klebol/Klecontroller_PCB/Cntrl_materials.xlsx

Rodzaj | Wartość | Obudowa | Ilość | link | Stan
Rezystor | 100k | 0603 | 2 | https://www.tme.eu/pl/details/rc0603fr-07100k/rezystory-smd/yageo/rc0603fr-07100kl/
Rezystor | 5k62 | 0603 | 1 | https://www.tme.eu/pl/details/era3aeb5621v/rezystory-smd/panasonic/
Rezystor | 1k87 | 0603 | 1 | https://www.tme.eu/pl/details/era3aeb1871v/rezystory-smd/panasonic/
Rezystor | 200R | 0603 | 1 | led dac inny
Rezystor | 0R | 0603 | 1 |  | Z
Rezystor | 20R | 0603 | 1 | led dac inny
Rezystor | 2k2 | 0603 | 4 | https://www.tme.eu/pl/details/wf06p-2k2-5%25/rezystory-smd/walsin/wf06p222jtl/
Rezystor | 10k | 0603 | 3 | https://www.tme.eu/pl/details/wf06p-10k-5%25/rezystory-smd/walsin/wf06p103jtl/
Rezystor | 22k | 0603 | 1 | https://www.tme.eu/pl/details/smd0603-22k-1%25/rezystory-smd/royal-ohm/0603saf2202t5e/
Rezystor | 1M | 0603 | 1 | https://www.tme.eu/pl/details/rc0603jr-071m/rezystory-smd/yageo/rc0603jr-071ml/
Kondensator | 4.7u 6.3V | 0603 | 3 | https://www.tme.eu/pl/details/cl10a475kp8nnnc/kondensatory-mlcc-smd/samsung/
Kondensator | 22u 6.3V | 0805 / 0603 | 1 | https://www.tme.eu/pl/details/cl21a226mqqnnng/kondensatory-mlcc-smd/samsung/
Kondensator | 10n 6.3V | 0603 | 3 | https://www.tme.eu/pl/details/gcm188r72a103ka37j/kondensatory-mlcc-smd/murata/
Kondensator | 10u | 0603 | 1 | https://www.tme.eu/pl/details/cl10a106mq8nnnc/kondensatory-mlcc-smd/samsung/
Kondensator | 100n | 0603 | 7 | https://www.tme.eu/pl/details/0603b104k500ct/kondensatory-mlcc-smd/walsin/
Kondensator | 1u | 0603 | 1 | https://www.tme.eu/pl/details/cl10b105ka8nnnc/kondensatory-mlcc-smd/samsung/
Kondensator | 10p | 0402 / 0603 | 4 | https://www.tme.eu/pl/details/0402n100f500ct/kondensatory-mlcc-smd/walsin/
Kondensator | 33n | 0402 / 0603 | 1 | https://www.tme.eu/pl/details/0402b333j160ct/kondensatory-mlcc-smd/walsin/
Kondensator | 2,2n | 0402 / 0603 | 2 | https://www.tme.eu/pl/details/0402b222k500ct/kondensatory-mlcc-smd/walsin/
Kondensator | 4,7p | 0402/ 0603 | 1 | https://www.tme.eu/pl/details/cc0402crnpo9bn4r7/kondensatory-mlcc-smd/yageo/
Kondensator | 1,5p | 0402 / 0603 | 1 | https://www.tme.eu/pl/details/grm1555c1h1r5ba01d/kondensatory-mlcc-smd/murata/
Kondensator | 1p | 0402 / 0603 | 1 | https://www.tme.eu/pl/details/cc0402crnpo9bn1r0/kondensatory-mlcc-smd/yageo/
Dioda LED | Niebieska | 0805 | 1 | https://www.tme.eu/pl/details/fyls-0805ubc/diody-led-smd-kolorowe/foryard/
Dioda LED | Czerwona | 0805 | 1 | https://www.tme.eu/pl/details/ll-s170vc-v1-1b/diody-led-smd-kolorowe/luckylight/
Dioda | 1A 50V | SMA | 1 | https://www.tme.eu/pl/details/s1a-jgd/diody-uniwersalne-smd/jgd-semiconductors/s1a/
Dioda Shottky | 1A 40V | SOD123 | 1 | https://www.tme.eu/pl/details/1n5819hw-7-f/diody-schottky-smd/diodes-incorporated/
Cewka | 4,7u 650mA | 1812 | 1 | https://www.tme.eu/pl/details/lqh32cn4r7m53l/dlawiki-smd-1210/murata/ | Z
Cewka | 39n | 0402 | 1 | https://www.tme.eu/pl/details/lqg15hs39nj02d/dlawiki-smd-0402/murata/
Cewka | 3,9n | 0402 | 1 | https://www.tme.eu/pl/details/lqg15hn3n9s02d/dlawiki-smd-0402/murata/
Cewka | 8,2n | 0402 | 1 | https://www.tme.eu/pl/details/cl02jt8n2-s/dlawiki-smd-0402/viking/
Cewka | 2,7n |  | 1 | https://www.tme.eu/pl/details/cl02st2n7-s/dlawiki-smd-0402/viking/
MOSFET | Typ P |  | 1 | https://www.tme.eu/pl/details/bxt520p02m/tranzystory-z-kanalem-p-smd/bridgelux/
Rezonator | 16MHz | HC49 / plaski | 2 | https://www.tme.eu/pl/details/16.00m-cfpx-218/rezonatory-kwarcowe-smd/iqd-frequency-products/lfxtal069392cutt/ | Z
Boost-converter | MIC2288 | TSOT-23-5 | 1 | https://www.tme.eu/pl/details/mic2288yd5-tr/regulatory-napiecia-uklady-dc-dc/microchip-technology/
Stabilizator | LD1117S33 | SOT-223 | 1 | https://www.tme.eu/pl/details/ld1117s33ctr/stabilizatory-napiecia-nieregulowane-ldo/stmicroelectronics/ | Z
Diody USB | USBLC6-2SC6 | SOT-23-6 | 1 | https://www.tme.eu/pl/details/usblc6-2sc6/diody-zabezpieczajace-drabinki/stmicroelectronics/
Gniazdo USB | Micro |  | 1 | https://www.tme.eu/pl/details/10103594-0001lf_c/zlacza-usb-i-ieee1394/amphenol-communications-solutions/10103594-0001lf/
Radio IC | nRF24L01+ | QFN-20 | 1 | https://www.tme.eu/pl/details/oky3362/moduly-pozostale/okystar/
Gniazdo antenowe | SMA |  | 1 | https://www.tme.eu/pl/details/rf2-143-t-17-50-g/zlacza-sma-smb-smc/adam-tech/
Akcelerometr | MPU-6050 | QFN24 | 1
Joystick |  |  | 2
Enkoder |  |  | 1 | https://www.tme.eu/pl/details/ec11e20-20p20c-sw/enkodery-inkrementalne/sr-passives/
Przycisk |  |  | 4 | https://www.tme.eu/pl/details/dtsm-66n-v-b/mikroprzelaczniki-tact/diptronics/
Mikrokontroler | STM32F401RBT6 | LQFP64 | 1 | https://www.tme.eu/pl/details/stm32f401rbt6/mikrokontrolery-st/stmicroelectronics/
 |  |  |  | https://www.tme.eu/pl/details/ndr-t/listwy-i-gniazda-kolkowe/ninigi/
 |  |  |  | https://www.tme.eu/pl/details/nsr-04/listwy-i-gniazda-kolkowe/ninigi/
 |  |  |  | https://www.tme.eu/pl/details/dg301-5.0-2p11/listwy-zaciskowe-do-druku/degson-electronics/dg301-5-0-02p-11-00a-h/
