klebol/Klecontroller_PCB/Controller_board.kicad_pcb

## KiCad design Controller_board.kicad_pcb (2023-11-11)

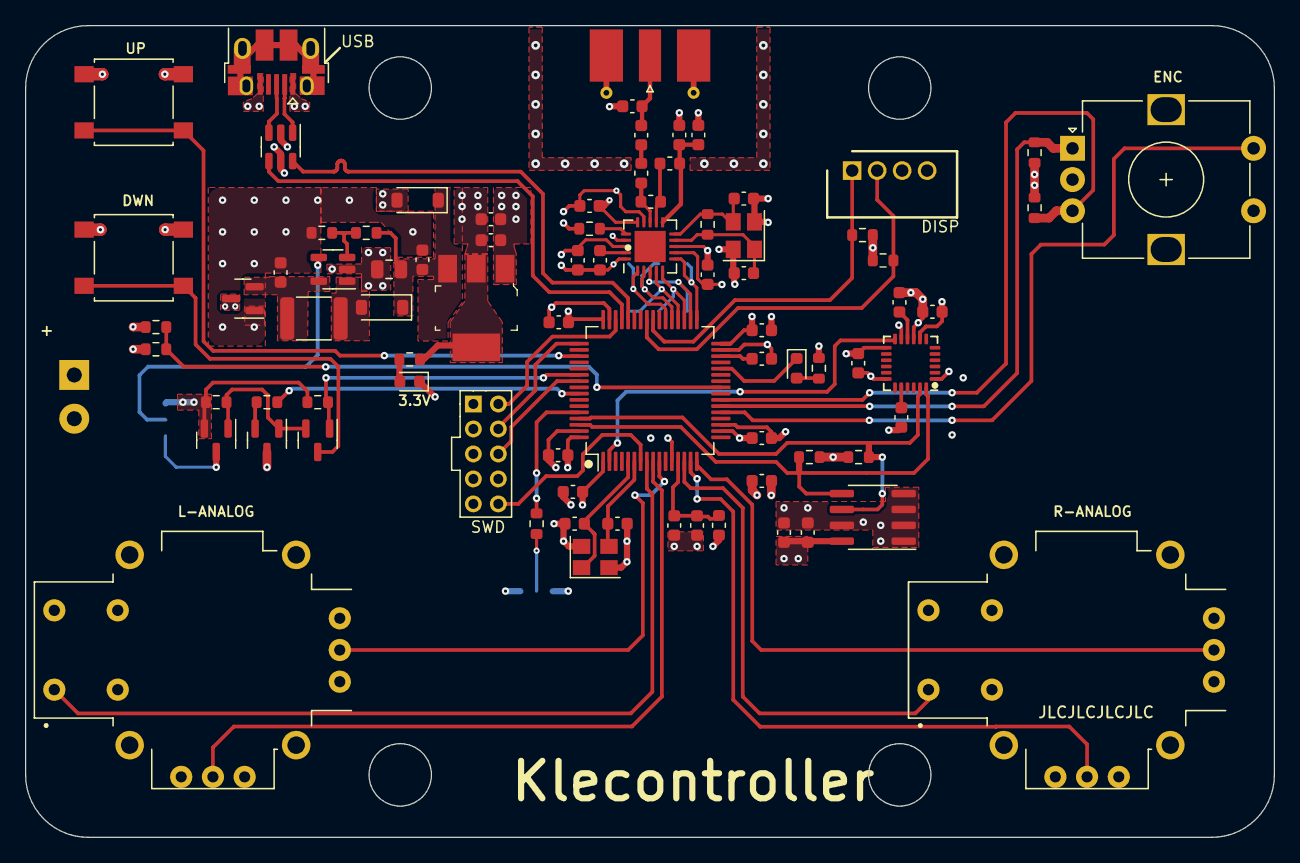
[picture p1: board Controller_board.kicad_pcb from above]

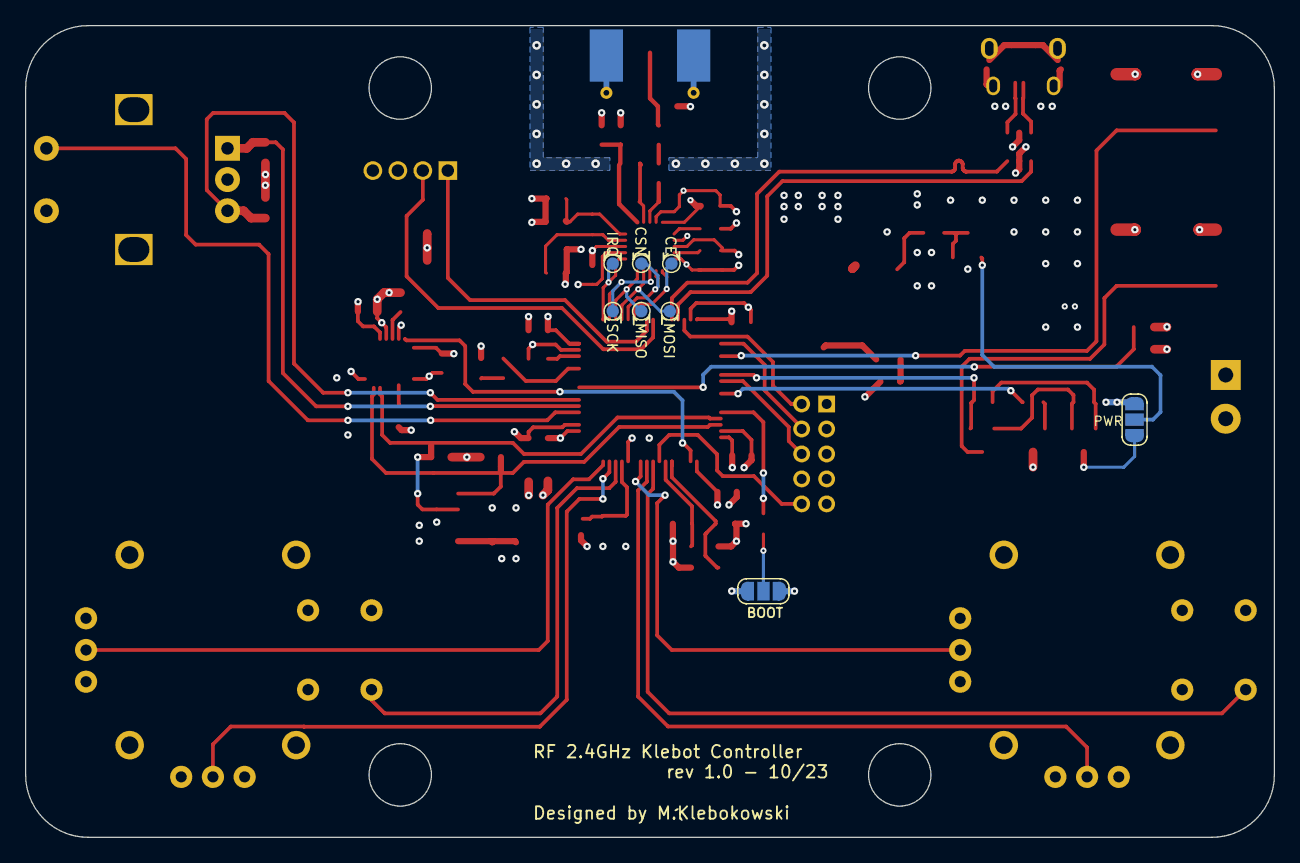
[picture p2: board Controller_board.kicad_pcb from below]

Board: 4 copper layers, 100.0 x 65.0 mm, 90 parts (8 on the bottom side), 65 nets.

Parts:
BT1: Battery; TerminalBlock_Phoenix_PT-1,5-2-3.5-H_1x02_P3.50mm_Horizontal
C1, C16: 4u7; C_0603_1608Metric
C2, C3, C4, C5, C6, C17, C18, C19, C21, C28, C31: 100n; C_0603_1608Metric
C7: 4u7 6.3V; C_0603_1608Metric
C8: 22uF 6.3V; C_0805_2012Metric
C9, C10: 100nF; C_0603_1608Metric
C11: 10uF; C_0603_1608Metric
C12: 1u; C_0603_1608Metric
C13, C20: 10n; C_0603_1608Metric
C14, C15, C24, C25: 10p; C_0603_1608Metric
C22: 1p5; C_0603_1608Metric
C23: 1p; C_0603_1608Metric
C26, C29: 2n2; C_0603_1608Metric
C27: 4p7; C_0603_1608Metric
C30: 33n; C_0603_1608Metric
C32: 2u2; C_0603_1608Metric
D1: BAT54C; SOT-23
D2, D5: 40V 1A; D_SOD-123
D3: LED RED; LED_0603_1608Metric
D4: LED BLUE; LED_0603_1608Metric
FB1: 120R; L_0603_1608Metric
J1: USB_B_Micro; USB_Micro-B_Amphenol_10103594-0001LF_Horizontal
J2: OLED_CONN; SHDR4W55P0X200_1X4_1000X500X530P
J3: SWD + UART; PinHeader_2x05_P2.00mm_Vertical
J4: SMA; SMA_Molex_73251-2120_EdgeMount_Horizontal
JP1: Powerup Mode; SolderJumper-3_P1.3mm_Open_RoundedPad1.0x1.5mm
L1: 4.7uH 650mA; L_1812_4532Metric
L3: 3n9; L_0603_1608Metric
L4: 8n2; L_0603_1608Metric
L5: 2n7; L_0603_1608Metric
Q1: BXT520P02M; SOT-23
Q2: DMP2045U; SOT-23
Q3: BC847-QR; SOT-23
R1: 5k62; R_0603_1608Metric
R2, R5, R16, R17, R18: 100k; R_0603_1608Metric
R3: 330R; R_0603_1608Metric
R4: 1k87; R_0603_1608Metric
R6: ?; R_0603_1608Metric
R7, R8, R9, R10: 2k2; R_0603_1608Metric
R11, R14, R15: 10k; R_0603_1608Metric
R12: 1M; R_0603_1608Metric
R13: 22k; R_0603_1608Metric
SW1: SW_SPDT; SolderJumper-3_P1.3mm_Open_RoundedPad1.0x1.5mm
SW2: Rotary Encoder; RotaryEncoder_Alps_EC12E-Switch_Vertical_H20mm
SW3, SW4: SW_Push; SW_SPST_B3S-1000
TP2: NRF_TestPoint_MOSI; TestPoint_Pad_D1.0mm
TP3: NRF_TestPoint_MISO; TestPoint_Pad_D1.0mm
TP4: NRF_TestPoint_SCK; TestPoint_Pad_D1.0mm
TP5: NRF_TestPoint_CSN; TestPoint_Pad_D1.0mm
TP6: NRF_TestPoint_CE; TestPoint_Pad_D1.0mm
TP7: NRF_TestPoint_IRQ; TestPoint_Pad_D1.0mm
U1: LD1117S33CTR; SOT-223
U2: MIC2288; TSOT-23-5
U3: USBLC6-2SC6; SOT-23-6
U4: STM32F401RBT6; LQFP-64_10x10mm_P0.5mm
U5: MPU-6050; InvenSense_QFN-24_4x4mm_P0.5mm
U6: nRF24L01P; QFN-20-1EP_4x4mm_P0.5mm_EP2.5x2.5mm
U7: M24C02-FMN; SOIC-8_3.9x4.9mm_P1.27mm
U8, U9: COM-09032; XDCR_COM-09032
Y1, Y2: 16 MHz; Crystal_SMD_3225-4Pin_3.2x2.5mm

Connections:
+3.3V: C1.1, C2.1, C3.1, C4.1, C5.1, C6.1, C10.1, C11.1, C17.1, C18.1, C19.1, C20.2, C21.2, C31.1, C32.1, FB1.1, J2.3, J3.1, R3.1, R6.2, R7.1, R8.1, R9.1, R10.1, R13.1, R14.1, R15.2, SW1.1 (A), U1.2 (VOUT), U1.4 (VOUT), U4.1 (VBAT), U4.19 (VDD), U4.32 (VDD), U4.48 (VDD), U4.64 (VDD), U5.8 (VLOGIC), U5.13 (VDD), U6.7 (VDD), U6.15 (VDD), U6.18 (VDD), U7.8 (VCC), U8.H1 (H+), U8.V1 (V+), U9.H1 (H+), U9.V1 (V+)
+5V: C8.1, C9.1, D2.1 (K), D5.1 (K), R1.1, U1.3 (VIN)
+BATT: BT1.1 (+), JP1.1 (A), Q1.3 (D), Q2.2 (S), R2.2, R16.1, R17.1
-BATT: BT1.2 (-), C1.2, C2.2, C3.2, C4.2, C5.2, C6.2, C7.2, C8.2, C9.2, C10.2, C11.2, C12.2, C13.2, C14.2, C15.2, C16.2, C17.2, C18.2, C19.2, C20.1, C21.1, C23.2, C24.2, C25.2, C26.1, C27.1, C28.1, C29.1, C30.2, C31.2, C32.2, D3.1 (K), J1.5 (GND), J2.4, J3.3, J3.5, J3.9, J4.2, Q1.1 (G), Q3.3 (E), R4.2, R5.1, SW1.3 (C), SW2.C, SW2.S2, SW3.1, SW4.1, U1.1 (GND), U2.2 (GND), U3.2 (GND), U4.12 (VSSA), U4.18 (VSS), U4.31 (VSS), U4.47 (VSS), U4.63 (VSS), U5.1 (CLKIN), U5.9 (AD0), U5.11 (FSYNC), U5.18 (GND), U6.8 (VSS), U6.14 (VSS), U6.17 (VSS), U6.20 (VSS), U7.1 (E0), U7.2 (E1), U7.3 (E2), U7.4 (VSS), U7.7 (~WC), U8.B2A (SEL-), U8.H3 (H-), U8.V3 (V-), U9.B2A (SEL-), U9.H3 (H-), U9.V3 (V-), Y1.2, Y1.4, Y2.2, Y2.4
BATTERY_ADC: R2.1, R5.2, U4.25 (PC5)
BOOT0: R11.1, U4.60 (BOOT0)
BUTTON_DOWN: D1.3, SW4.2
BUTTON_UP: SW3.2, U4.51 (PC10)
EN: JP1.2 (C), U2.4 (EN)
ENC_A: R14.2, SW2.A, U4.22 (PA6)
ENC_B: R15.1, SW2.B, U4.23 (PA7)
ENC_BUTTON: SW2.S1, U4.21 (PA5)
I2C_SCL: R9.2, U4.61 (PB8), U5.23 (SCL), U7.6 (SCL)
I2C_SDA: R10.2, U4.62 (PB9), U5.24 (SDA), U7.5 (SDA)
JOY1_ADC_X: U4.10 (PC2), U8.H2 (H)
JOY1_ADC_Y: U4.9 (PC1), U8.V2 (V)
JOY1_BUTTON: U4.8 (PC0), U8.B1A (SEL+)
JOY2_ADC_X: U4.16 (PA2), U9.H2 (H)
JOY2_ADC_Y: U4.15 (PA1), U9.V2 (V)
JOY2_BUTTON: U4.14 (PA0), U9.B1A (SEL+)
KEEP_ALIVE: R18.2, U4.57 (PB5)
LATCH_POWERUP: JP1.3 (B), Q2.3 (D)
MPU-6050_IRQ: U4.2 (PC13), U5.12 (INT)
NRF_ANT1: L4.2, L5.1, U6.12 (ANT1)
NRF_ANT2: L3.1, L4.1, U6.13 (ANT2)
NRF_CE: TP6.1, U4.38 (PC7), U6.1 (CE)
NRF_CSN: TP5.1, U4.37 (PC6), U6.2 (CSN)
NRF_IRQ: TP7.1, U4.33 (PB12), U6.6 (IRQ)
NRF_MISO: TP3.1, U4.35 (PB14), U6.5 (MISO)
NRF_MOSI: TP2.1, U4.36 (PB15), U6.4 (MOSI)
NRF_SCK: TP4.1, U4.34 (PB13), U6.3 (SCK)
NRF_VDD_PA: C26.2, C27.2, L5.2, U6.11 (VDD_PA)
NRF_XC1: C25.1, R12.2, U6.10 (XC1), Y2.3
NRF_XC2: C24.1, R12.1, U6.9 (XC2), Y2.1
NRST: J3.10, U4.7 (NRST)
unnamed: C22.1, L3.2
unnamed: C22.2, C23.1, J4.1
unnamed: D2.2 (A), L1.2, U2.1 (SW)
unnamed: D3.2 (A), R3.2
unnamed: D4.2 (A), R6.1
unnamed: D4.1 (K), U4.28 (PB2)
unnamed: C7.1, L1.1, Q1.2 (S), U2.5 (VIN)
unnamed: D1.2, Q2.1 (G), Q3.1 (C), R17.2
unnamed: Q3.2 (B), R18.1
unnamed: R11.2, SW1.2 (B)
unnamed: R1.2, R4.1, U2.3 (FB)
unnamed: C14.1, U4.5 (PH0), Y1.1
unnamed: C15.1, U4.6 (PH1), Y1.3
unnamed: C16.1, U4.30 (VCAP1)
unnamed: C12.1, C13.1, FB1.2, U4.13 (VREF+)
unnamed: C29.2, U5.20 (CPOUT)
unnamed: C28.2, U5.10 (REGOUT)
unnamed: C30.1, U6.19 (DVDD)
unnamed: R13.2, U6.16 (IREF)
OLED_SCL: J2.2, R7.2, U4.41 (PA8)
OLED_SDA: J2.1, R8.2, U4.40 (PC9)
Power_Btn: D1.1, R16.2, U4.54 (PD2)
SWCLK: J3.4, U4.49 (PA14)
SWDIO: J3.2, U4.46 (PA13)
SWO: J3.6, U4.55 (PB3)
USB_CONN_D+: J1.3 (D+), U3.3 (I/O2)
USB_CONN_D-: J1.2 (D-), U3.1 (I/O1)
USB_D+: U3.4 (I/O2), U4.45 (PA12)
USB_D-: U3.6 (I/O1), U4.44 (PA11)
V_USB: D5.2 (A), J1.1 (VBUS), U3.5 (VBUS)
