klebol/Klecontroller_PCB/(commit log)

2023-10-06 finalising layout
    [Battery_Power.kicad_sch, Cntrl_materials.xlsx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]
2023-11-11 Added Gerbers
    [Controller_board-B_Cu.gbl, Controller_board-B_Mask.gbs, Controller_board-B_Paste.gbp, Controller_board-B_Silkscreen.gbo, Controller_board-Edge_Cuts.gm1, Controller_board-F_Cu.gtl, Controller_board-F_Mask.gts, Controller_board-F_Paste.gtp]
